n1-c00/PIcroscope/hardware/images/microscope.png

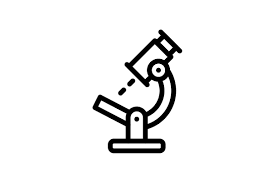
hardware/images/microscope.png
