n1-c00/PIcroscope/references/adafruit_OV5640_schematic.png

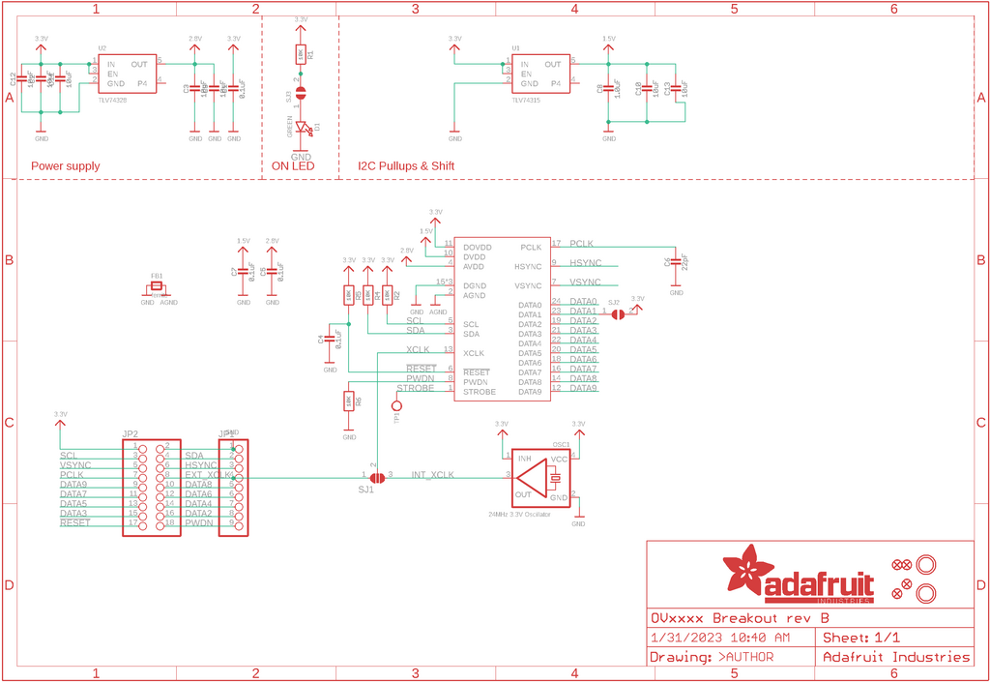
references/adafruit_OV5640_schematic.png
