n1-c00/PIcroscope/references/picowbell_camera_schematic.png

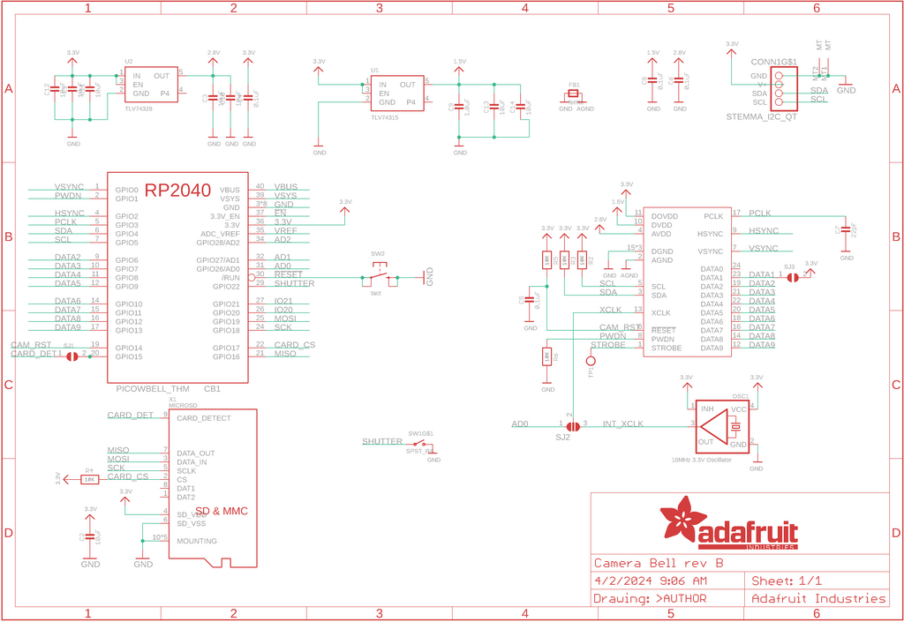
references/picowbell_camera_schematic.png
