n1-c00/PIcroscope/references/RP2350B-QFN80.step

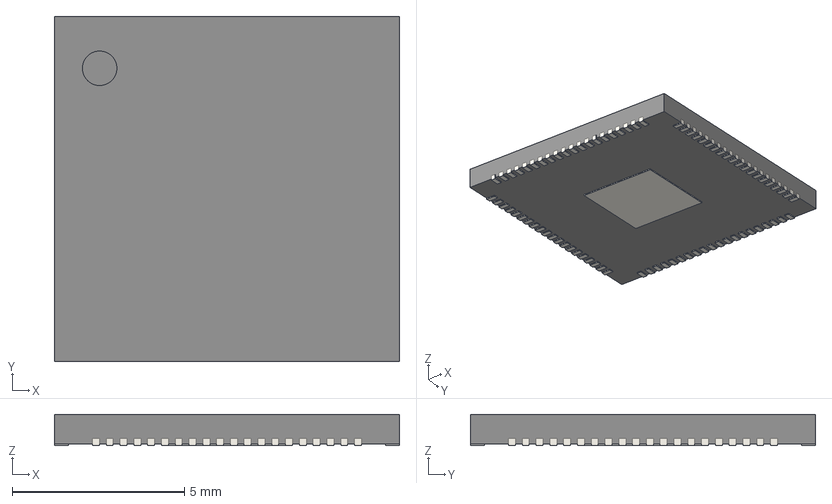
[picture p4: CAD file, 2025-05-05]
references/RP2350B-QFN80.step
10.0 x 10.0 x 0.9 mm
