n1-c00/PIcroscope/hardware/Picroscope_Schematic.pdf

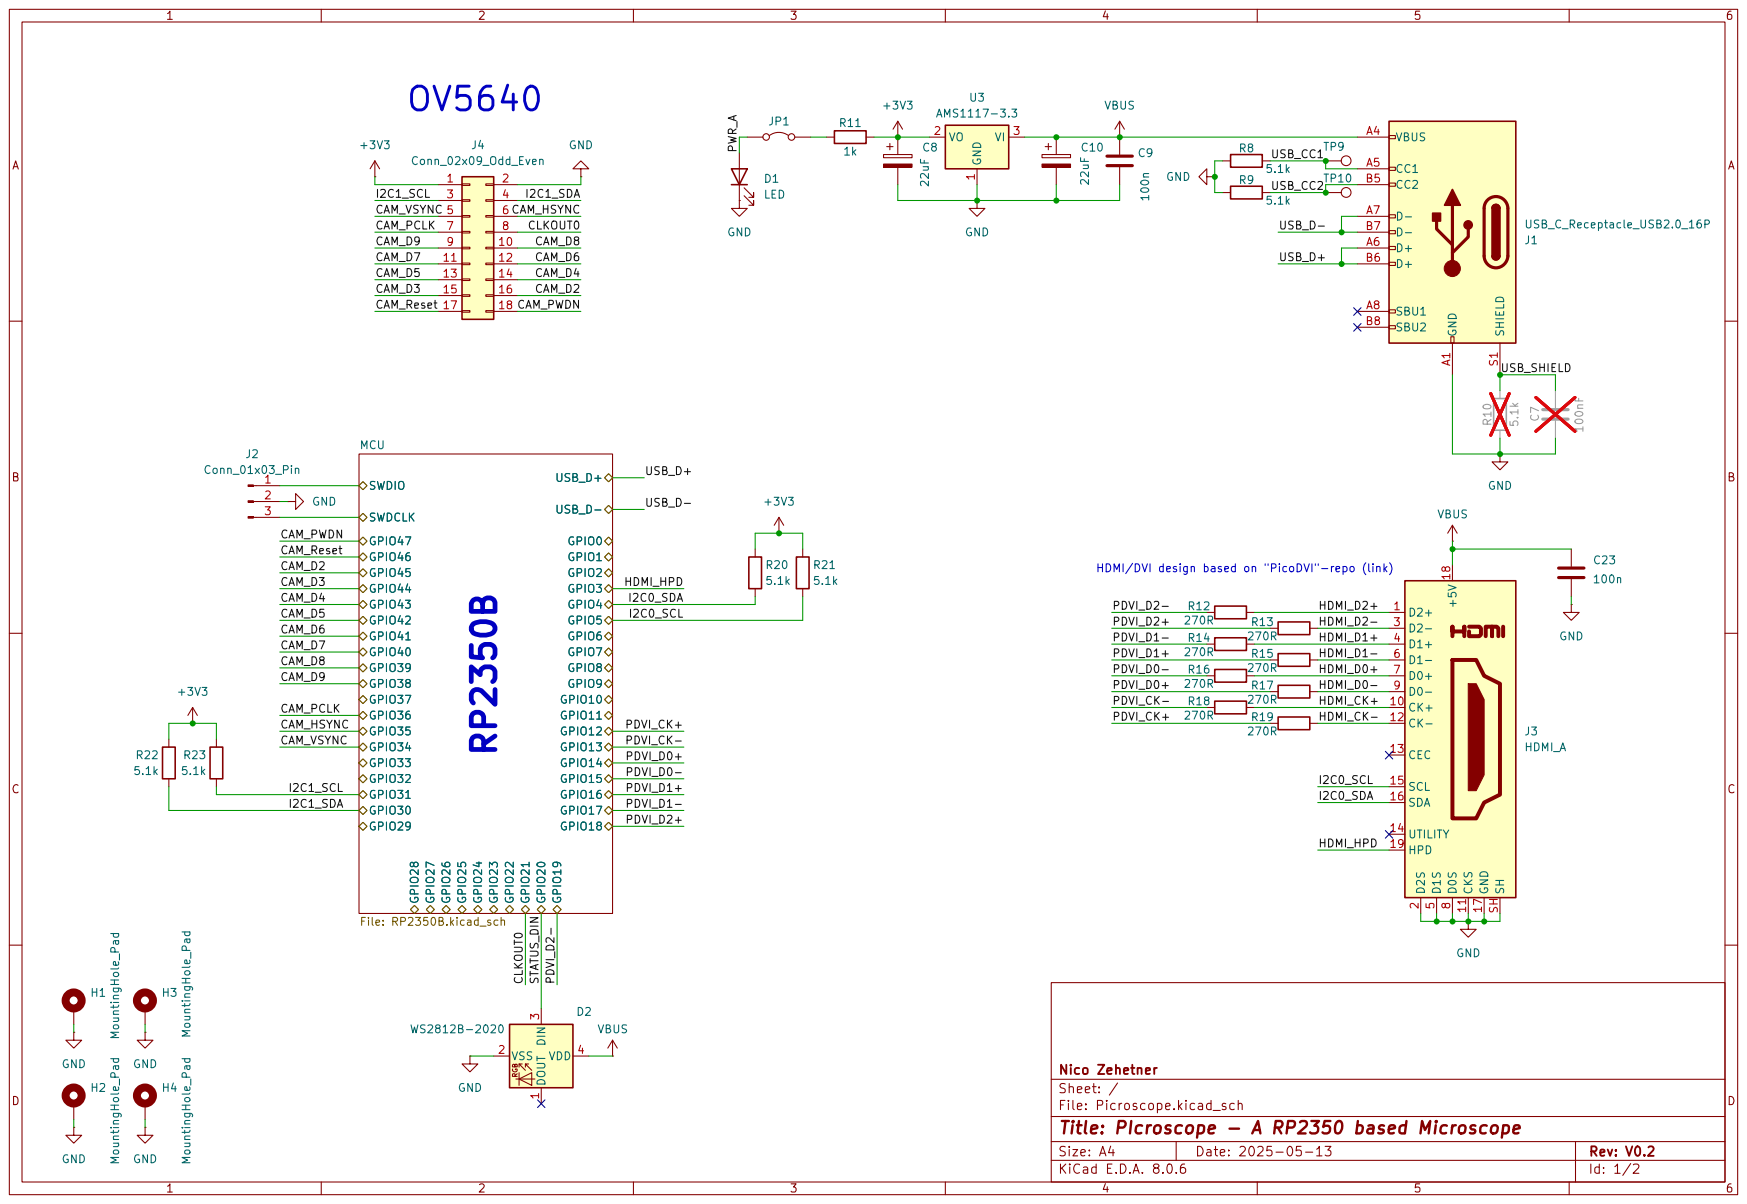
[picture p5: page 1]

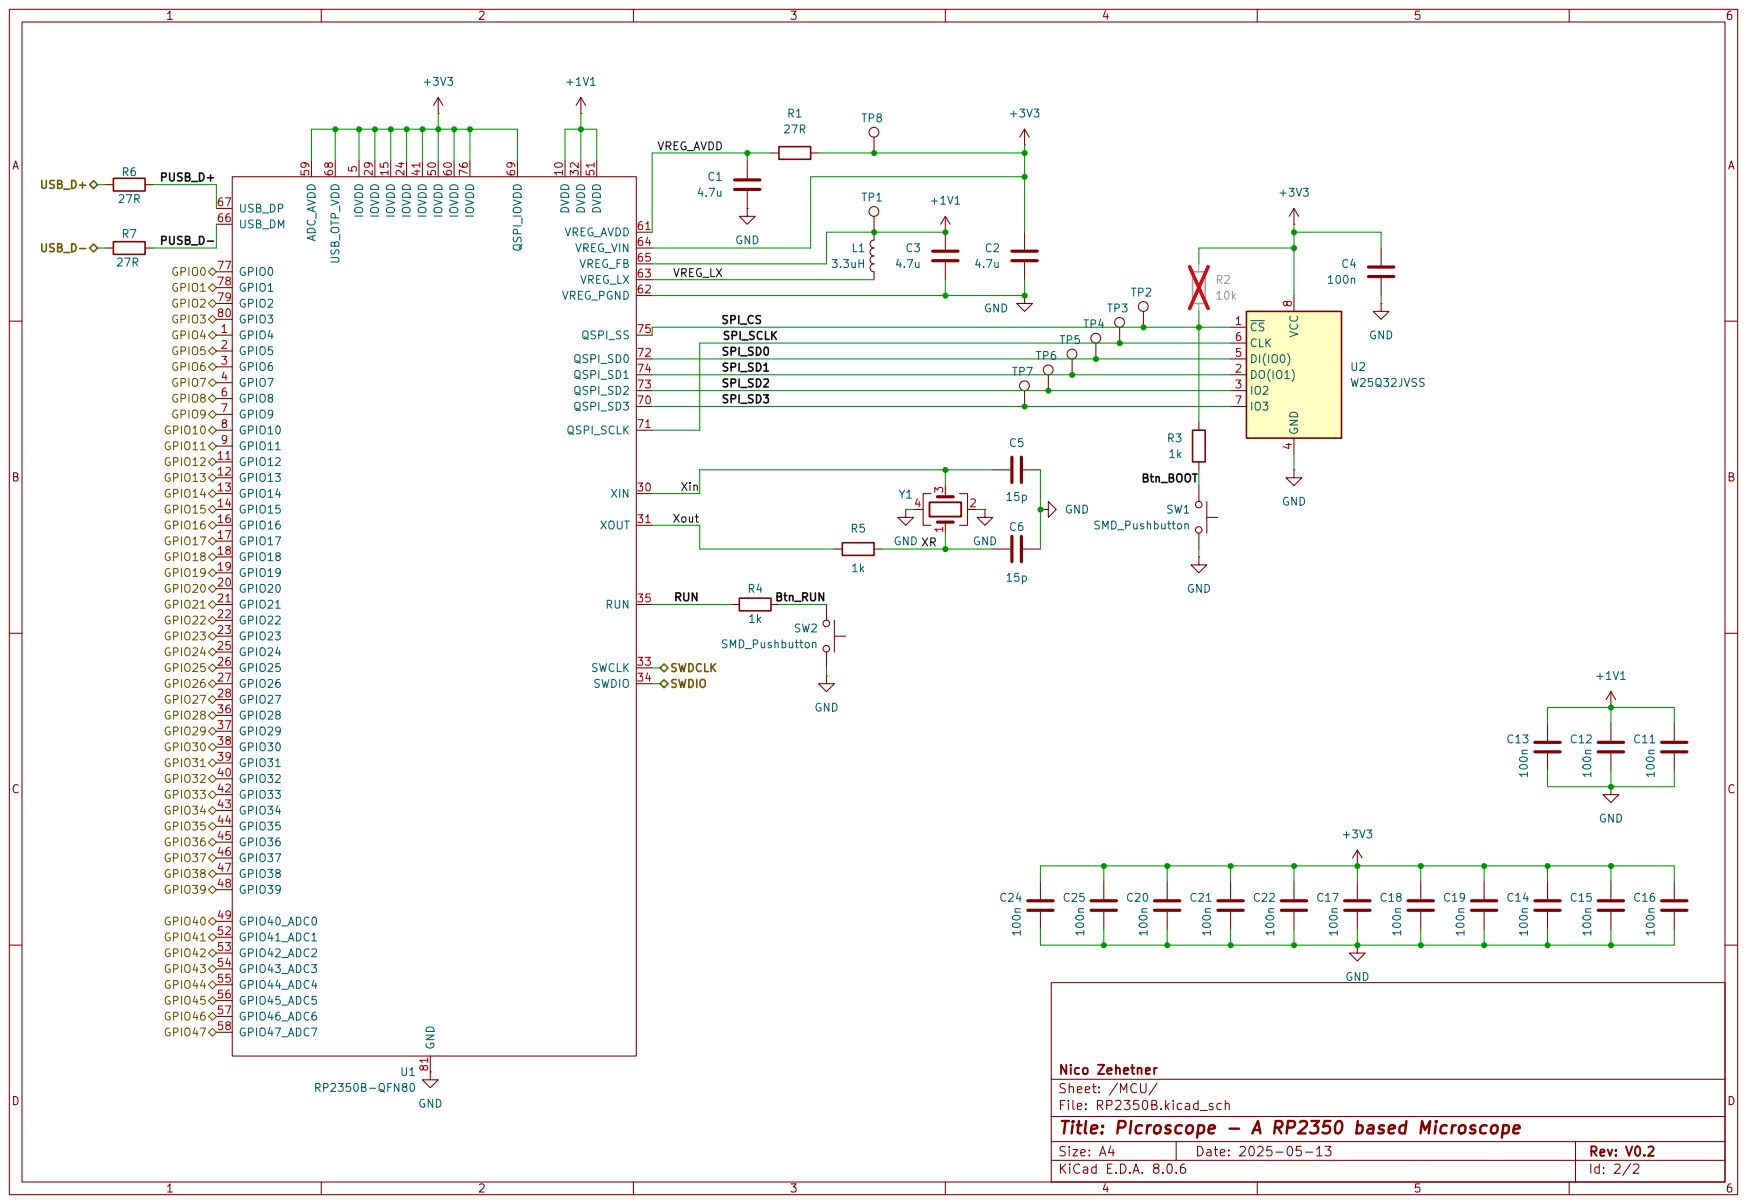
[picture p6: page 2]
