n1-c00/PIcroscope/hardware/Picroscope.pdf

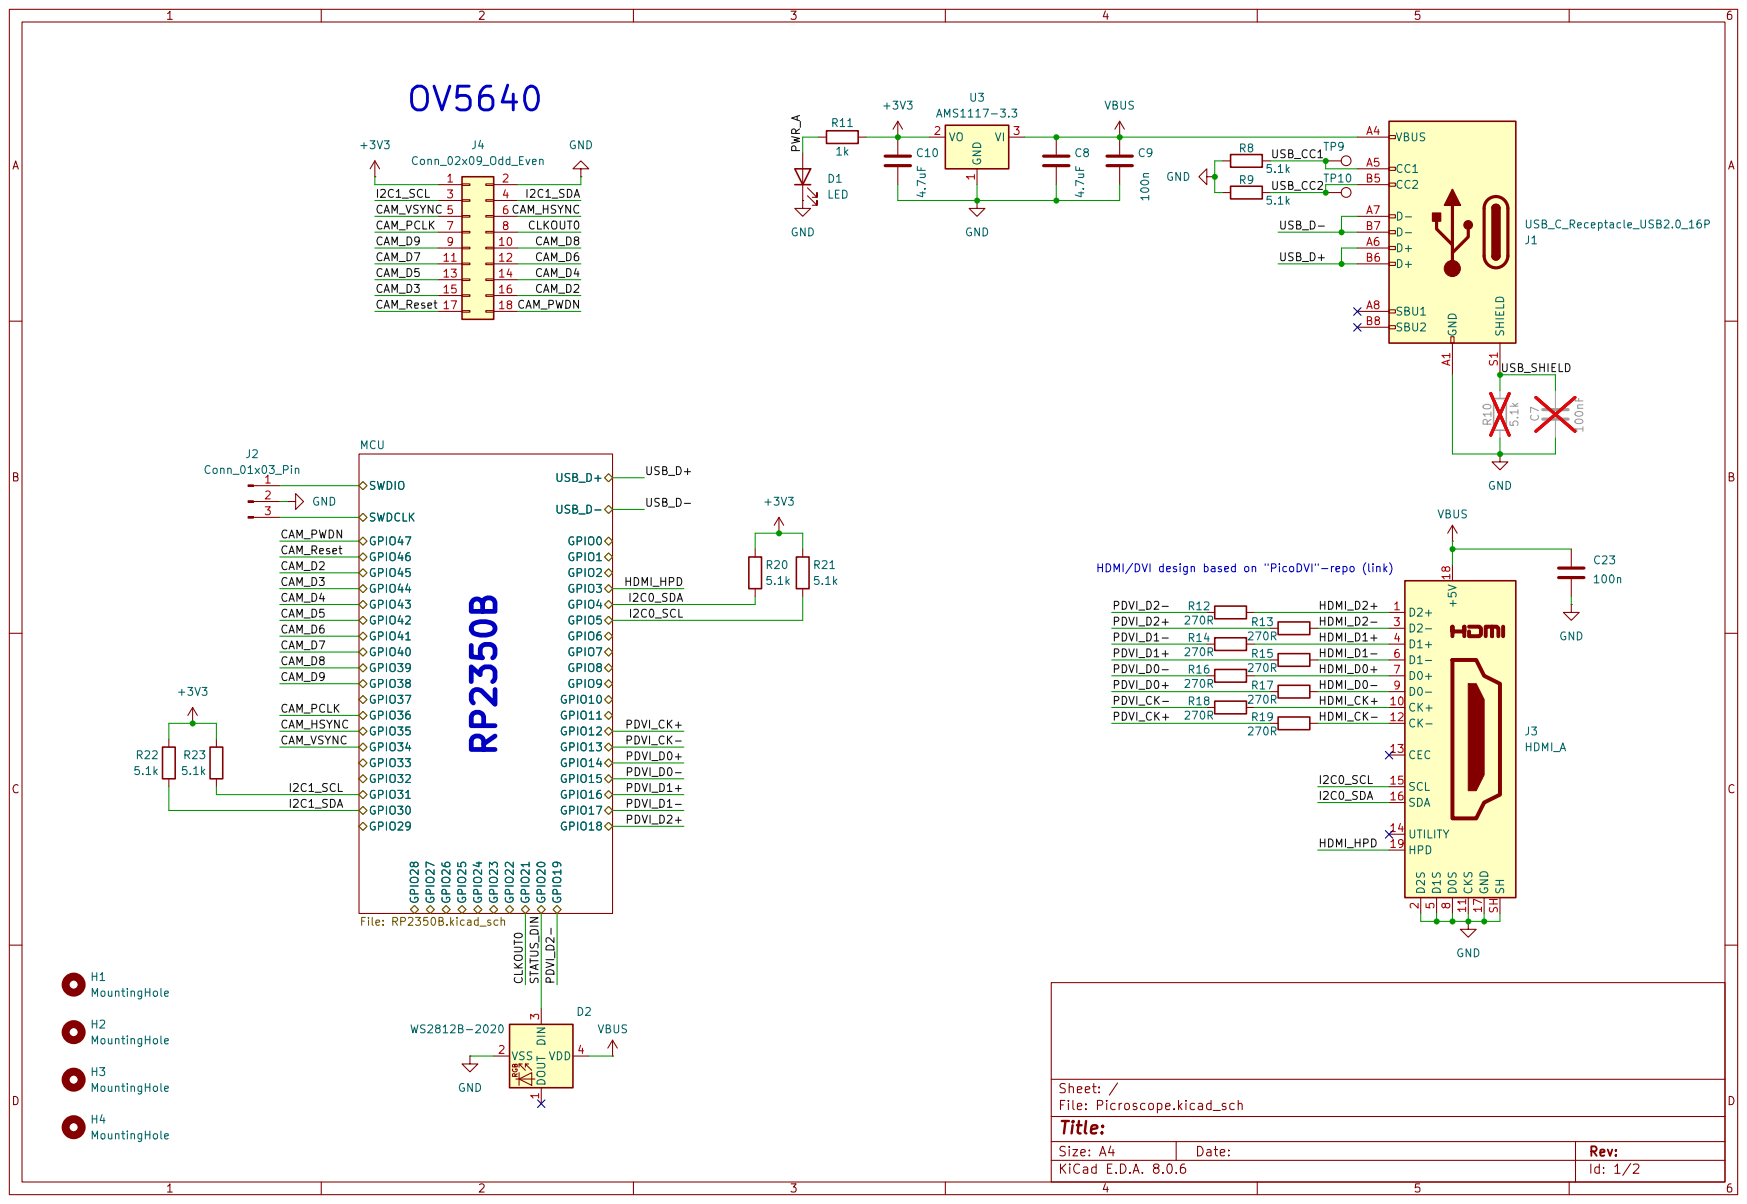
[picture p7: page 1]

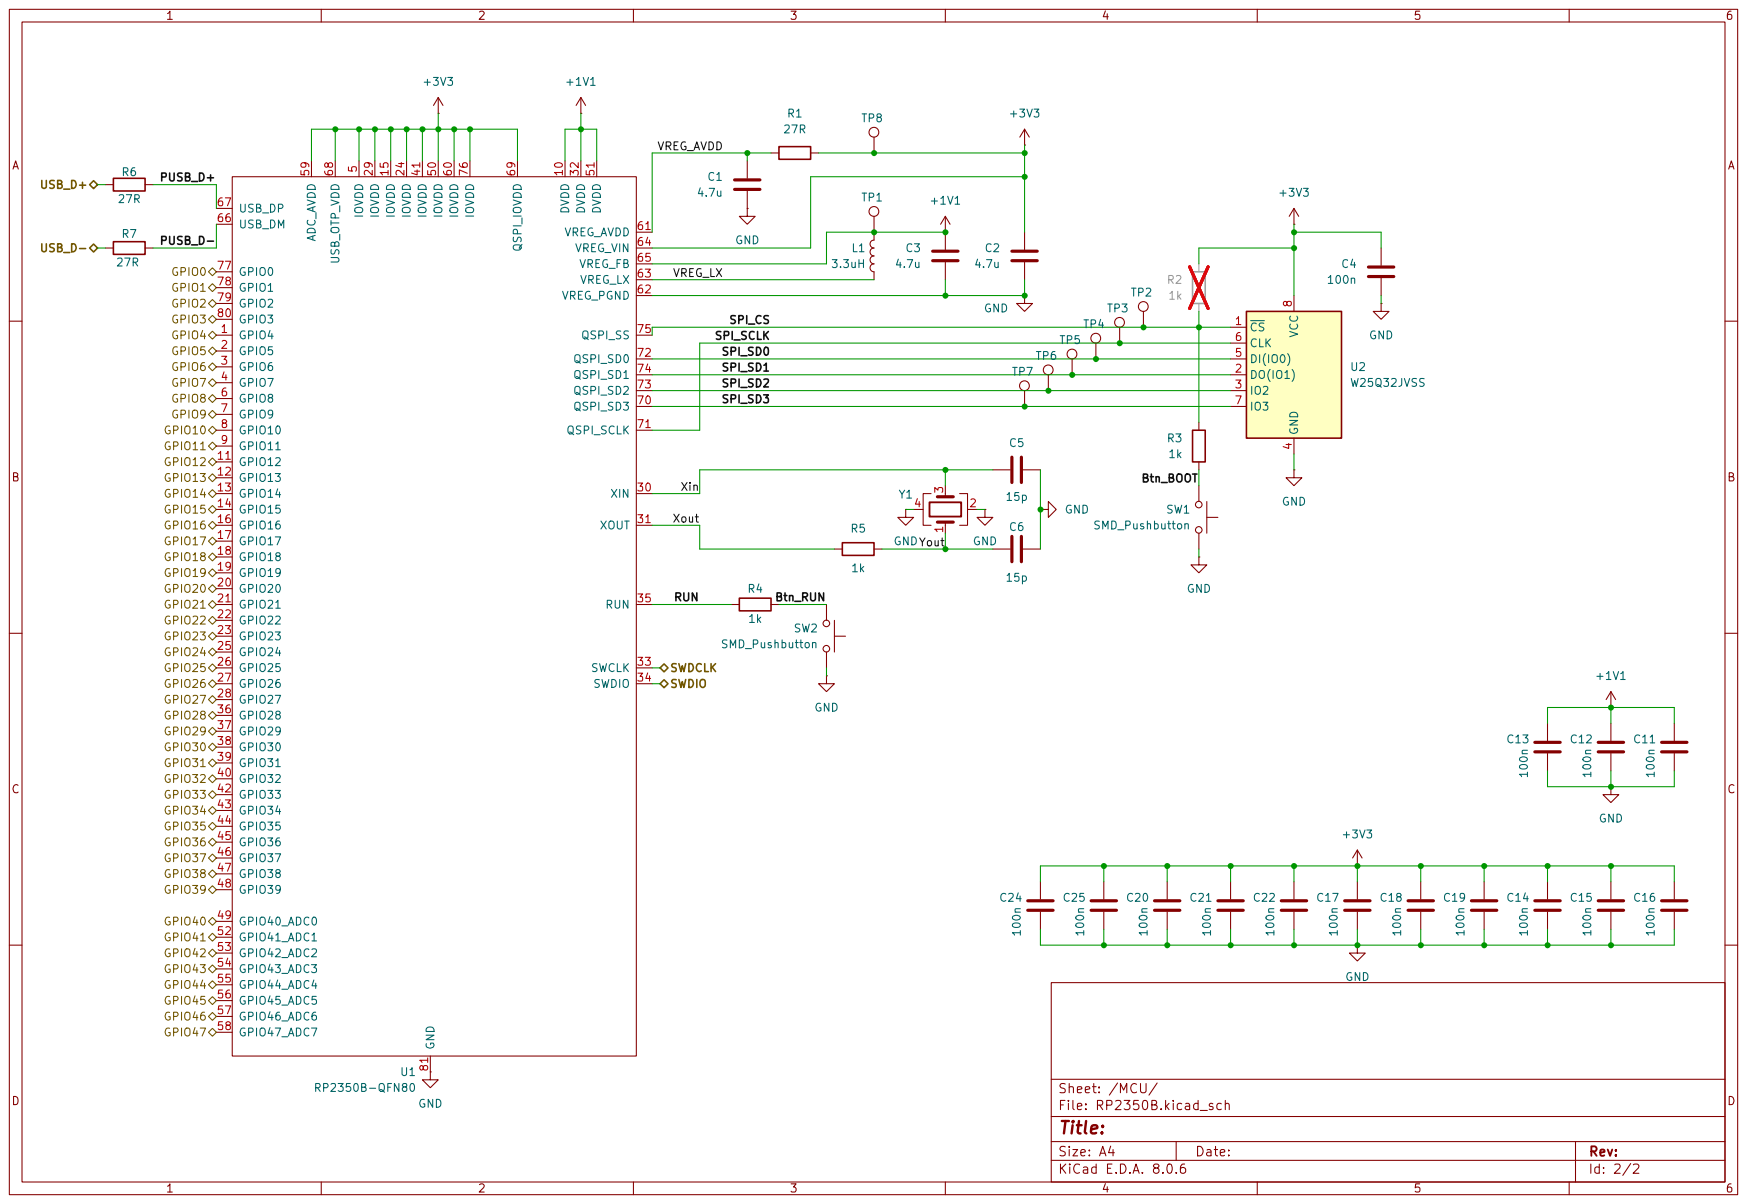
[picture p8: page 2]
