n1-c00/PIcroscope/hardware/Picroscope.kicad_pcb

## KiCad design hardware/Picroscope.kicad_pcb (2025-05-27)

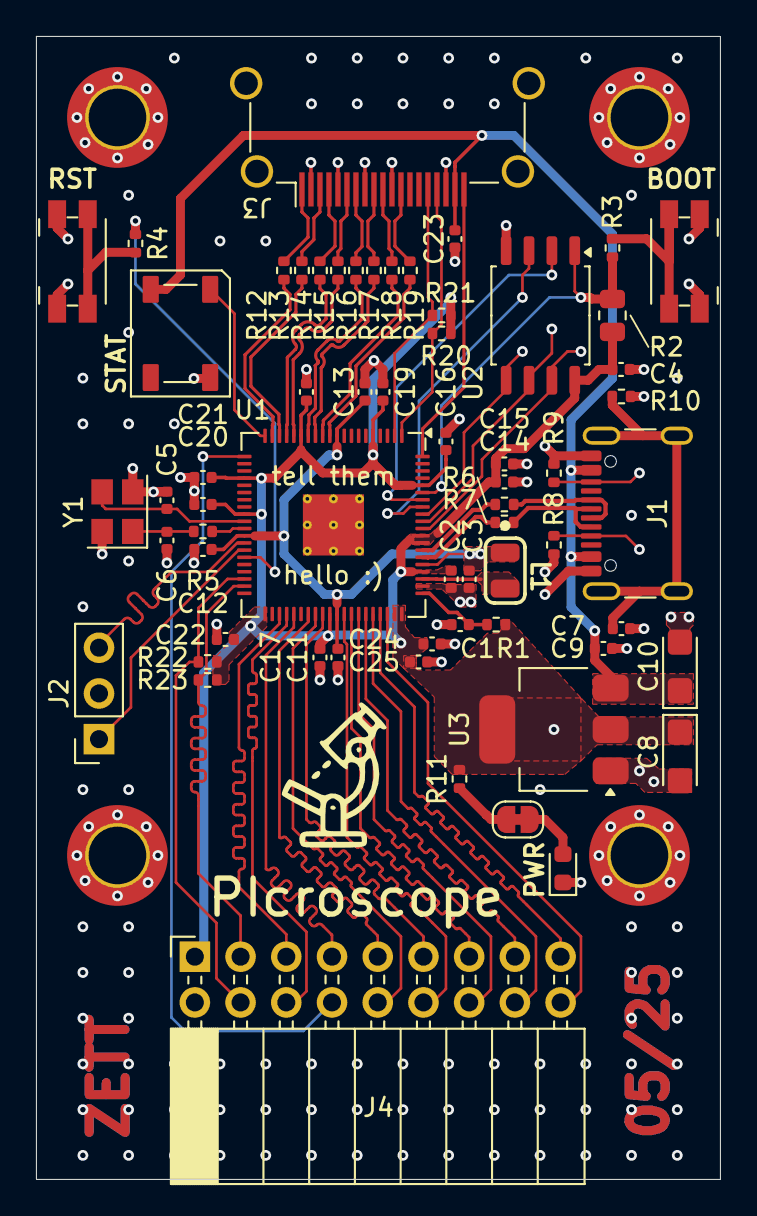
[picture p9: board Picroscope.kicad_pcb from above]

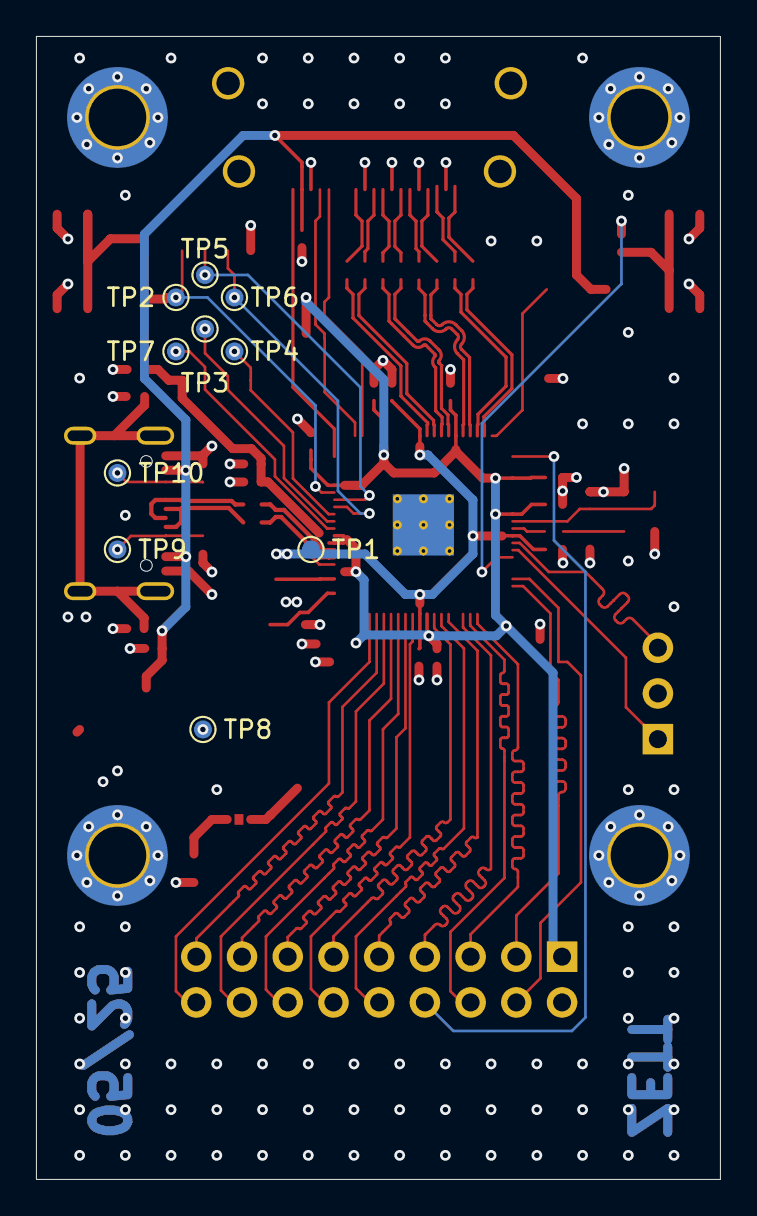
[picture p10: board Picroscope.kicad_pcb from below]

Board: 4 copper layers, 38.0 x 63.5 mm, 76 parts (10 on the bottom side), 65 nets.

Parts:
C1, C2, C3: 4.7u; C_0402_1005Metric
C4, C9, C11, C12, C13, C14, C15, C16, C17, C18, C19, C20, C21, C22, C23, C24, C25: 100n; C_0402_1005Metric
C5, C6: 15p; C_0402_1005Metric
C7: 100nF; C_0402_1005Metric
C8, C10: 22uF; CP_EIA-3216-18_Kemet-A
D1: LED; LED_0603_1608Metric
D2: WS2812B-2020; LED_WS2812B_PLCC4_5.0x5.0mm_P3.2mm
H1, H2, H3, H4: MountingHole_Pad; MountingHole_3.2mm_M3_DIN965_Pad_TopBottom
J1: USB_C_Receptacle_USB2.0_16P; USB_C_Receptacle_GCT_USB4105-xx-A_16P_TopMnt_Horizontal
J2: Conn_01x03_Pin; PinSocket_1x03_P2.54mm_Vertical
J3: HDMI_A; HDMI_A_Amphenol_10029449-x01xLF_Horizontal
J4: Conn_02x09_Odd_Even; PinSocket_2x09_P2.54mm_Horizontal
JP1: Jumper_2_Bridged; SolderJumper-2_P1.3mm_Bridged_RoundedPad1.0x1.5mm
L1: 3.3uH; RP235x_Inductor
R1, R6, R7: 27R; R_0402_1005Metric
R2: 1k; R_0805_2012Metric
R3, R4, R5, R11: 1k; R_0402_1005Metric
R8, R9, R10, R20, R21, R22, R23: 5.1k; R_0402_1005Metric
R12, R13, R14, R15, R16, R17, R18, R19: 270R; R_0402_1005Metric
SW1, SW2: SMD_Pushbutton; Panasonic_EVQPUJ_EVQPUA
TP1, TP2, TP3, TP4, TP5, TP6, TP7, TP8, TP9, TP10: TestPoint; TestPoint_Pad_D1.0mm
U1: RP2350B-QFN80; QFN-80-1EP_10x10mm_P0.4mm_EP3.4x3.4mm_ThermalVias
U2: W25Q32JVSS; SOIC-8_5.23x5.23mm_P1.27mm
U3: AMS1117-3.3; SOT-223-3_TabPin2
Y1: ABM8-272-T3; Crystal_SMD_3225-4Pin_3.2x2.5mm

Connections:
+1V1: C3.1, C11.1, C12.1, C13.1, L1.1, TP1.1, U1.10 (DVDD), U1.32 (DVDD), U1.51 (DVDD), U1.65 (VREG_FB)
+3V3: C2.1, C4.1, C8.1, C14.1, C15.1, C16.1, C17.1, C18.1, C19.1, C20.1, C21.1, C22.1, C24.1, C25.1, J4.1, R1.1, R2.1, R11.2, R20.1, R21.1, R22.1, R23.1, TP8.1, U1.5 (IOVDD), U1.15 (IOVDD), U1.24 (IOVDD), U1.29 (IOVDD), U1.41 (IOVDD), U1.50 (IOVDD), U1.59 (ADC_AVDD), U1.60 (IOVDD), U1.64 (VREG_VIN), U1.68 (USB_OTP_VDD), U1.69 (QSPI_IOVDD), U1.76 (IOVDD), U2.8 (VCC), U3.2 (VO)
/CAM_D2: J4.16, U1.56 (GPIO45_ADC5)
/CAM_D3: J4.15, U1.55 (GPIO44_ADC4)
/CAM_D4: J4.14, U1.54 (GPIO43_ADC3)
/CAM_D5: J4.13, U1.53 (GPIO42_ADC2)
/CAM_D6: J4.12, U1.52 (GPIO41_ADC1)
/CAM_D7: J4.11, U1.49 (GPIO40_ADC0)
/CAM_D8: J4.10, U1.48 (GPIO39)
/CAM_D9: J4.9, U1.47 (GPIO38)
/CAM_HSYNC: J4.6, U1.44 (GPIO35)
/CAM_PCLK: J4.7, U1.45 (GPIO36)
/CAM_PWDN: J4.18, U1.58 (GPIO47_ADC7)
/CAM_Reset: J4.17, U1.57 (GPIO46_ADC6)
/CAM_VSYNC: J4.5, U1.43 (GPIO34)
/CLKOUT0: J4.8, U1.21 (GPIO21)
/HDMI_CK+: J3.10 (CK+), R18.2
/HDMI_CK-: J3.12 (CK-), R19.2
/HDMI_D0+: J3.7 (D0+), R16.2
/HDMI_D0-: J3.9 (D0-), R17.2
/HDMI_D1+: J3.4 (D1+), R14.2
/HDMI_D1-: J3.6 (D1-), R15.2
/HDMI_D2+: J3.1 (D2+), R12.2
/HDMI_D2-: J3.3 (D2-), R13.2
/HDMI_HPD: J3.19 (HPD), U1.80 (GPIO3)
/I2C0_SCL: J3.15 (SCL), R21.2, U1.2 (GPIO5)
/I2C0_SDA: J3.16 (SDA), R20.2, U1.1 (GPIO4)
/I2C1_SCL: J4.3, R23.2, U1.39 (GPIO31)
/I2C1_SDA: J4.4, R22.2, U1.38 (GPIO30)
/MCU/Btn_BOOT: R3.2, SW1.2
/MCU/Btn_RUN: R4.1, SW2.2
/MCU/PUSB_D+: R6.1, U1.67 (USB_DP)
/MCU/PUSB_D-: R7.1, U1.66 (USB_DM)
/MCU/RUN: R4.2, U1.35 (RUN)
/MCU/SPI_CS: R2.2, R3.1, TP2.1, U1.75 (QSPI_SS), U2.1 (~CS)
/MCU/SPI_SCLK: TP3.1, U1.71 (QSPI_SCLK), U2.6 (CLK)
/MCU/SPI_SD0: TP4.1, U1.72 (QSPI_SD0), U2.5 (DI(IO0))
/MCU/SPI_SD1: TP5.1, U1.74 (QSPI_SD1), U2.2 (DO(IO1))
/MCU/SPI_SD2: TP6.1, U1.73 (QSPI_SD2), U2.3 (IO2)
/MCU/SPI_SD3: TP7.1, U1.70 (QSPI_SD3), U2.7 (IO3)
/MCU/SWDCLK: J2.3, U1.33 (SWCLK)
/MCU/SWDIO: J2.1, U1.34 (SWDIO)
/MCU/VREG_AVDD: C1.1, R1.2, U1.61 (VREG_AVDD)
/MCU/VREG_LX: L1.2, U1.63 (VREG_LX)
/MCU/Xin: C5.2, U1.30 (XIN), Y1.3
/MCU/Xout: R5.1, U1.31 (XOUT)
/MCU/Yout: C6.2, R5.2, Y1.1
/PDVI_CK+: R19.1, U1.11 (GPIO12)
/PDVI_CK-: R18.1, U1.12 (GPIO13)
/PDVI_D0+: R17.1, U1.13 (GPIO14)
/PDVI_D0-: R16.1, U1.14 (GPIO15)
/PDVI_D1+: R15.1, U1.16 (GPIO16)
/PDVI_D1-: R14.1, U1.17 (GPIO17)
/PDVI_D2+: R13.1, U1.18 (GPIO18)
/PDVI_D2-: R12.1, U1.19 (GPIO19)
/PWR_A: D1.2 (A), JP1.1 (A)
/STATUS_DIN: D2.3 (DIN), U1.20 (GPIO20)
/USB_CC1: J1.A5 (CC1), R8.2, TP9.1
/USB_CC2: J1.B5 (CC2), R9.2, TP10.1
/USB_D+: J1.A6 (D+), J1.B6 (D+), R6.2
/USB_D-: J1.A7 (D-), J1.B7 (D-), R7.2
/USB_SHIELD: C7.1, J1.S1 (SHIELD), R10.2
GND: C1.2, C2.2, C3.2, C4.2, C5.1, C6.1, C7.2, C8.2, C9.2, C10.2, C11.2, C12.2, C13.2, C14.2, C15.2, C16.2, C17.2, C18.2, C19.2, C20.2, C21.2, C22.2, C23.1, C24.2, C25.2, D1.1 (K), D2.2 (VSS), H1.1, H2.1, H3.1, H4.1, J1.A1 (GND), J1.A12 (GND), J1.B1 (GND), J1.B12 (GND), J2.2, J3.2 (D2S), J3.5 (D1S), J3.8 (D0S), J3.11 (CKS), J3.17 (GND), J3.SH, J4.2, R8.1, R9.1, R10.1, SW1.1, SW2.1, U1.62 (VREG_PGND), U1.81 (GND), U2.4 (GND), U3.1 (GND), Y1.2, Y1.4
unnamed: JP1.2 (B), R11.1
VBUS: C9.1, C10.1, C23.2, D2.4 (VDD), J1.A4 (VBUS), J1.A9 (VBUS), J1.B4 (VBUS), J1.B9 (VBUS), J3.18 (+5V), U3.3 (VI)
