n1-c00/PIcroscope/(threads)

Thread 1 (2025-06-05):

Xtal not oscillating

n1-c00, 2025-06-05:
Currently, Y1 (the external Quartz) shows no sign of oscillating in the first batch I ordered. I already tried:

**1. Measuring the Xin/Xout traces with a Scope:** This did not show any oscillation, but that could also be caused by the extra capacitence cause by the probe.
**2. Checking for continuity/verifying the PCB-Layout:** There could be an error as the recommended capacitors for the XTal are for a 2-Layer-Board and I am using a 4-Layer-Board, so stray capacitance might be higher...
**3. Testing if a external Signal to Xin would start up the IC:** This worked and the uC is working just fine when doing this!
