n1-c00/PIcroscope/(commit log)

2025-03-28 added length tuning to 'crucial' traces except qspi
    [Picroscope.kicad_pcb, Picroscope.kicad_sch]
2025-05-03 final push for PCB V0.1
    [Picroscope.kicad_pcb]
2025-05-05 changed C8 & C10 to tantalum caps
    [Picroscope.kicad_pcb, Picroscope.kicad_sch]
2025-05-05 added gitignore
    [Picroscope-B_Cu.gbr, Picroscope-B_Mask.gbr, Picroscope-B_Paste.gbr, Picroscope-B_Silkscreen.gbr, Picroscope-Edge_Cuts.gbr, Picroscope-F_Cu.gbr, Picroscope-F_Mask.gbr, Picroscope-F_Paste.gbr]
2025-05-27 fixed short to GND on CLKOUT0
    [Picroscope.kicad_pcb, Picroscope.kicad_sch, RP2350B.kicad_sch]
